velechit/HomeLAB/README.md

# HomeLAB
A miniature electronics lab (Oscilloscope + FuncGen + Breadboard + Arduino) for hobbyists
