velechit/HomeLAB/board/Oscilloscope/README.md

This directory will contain the KiCad project of the HomeLAB Oscilloscope
