velechit/HomeLAB/board/FuncGen/doc/board.pdf

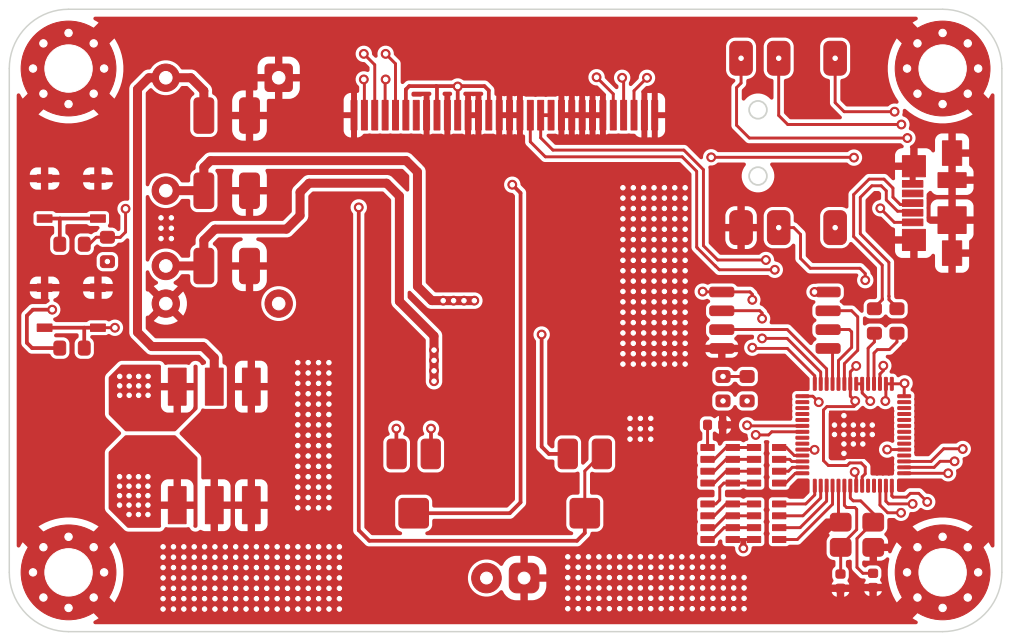
[picture p1: page 1]

Id: 1/8 Title: File: FuncGen.kicad_pcb Sheet:

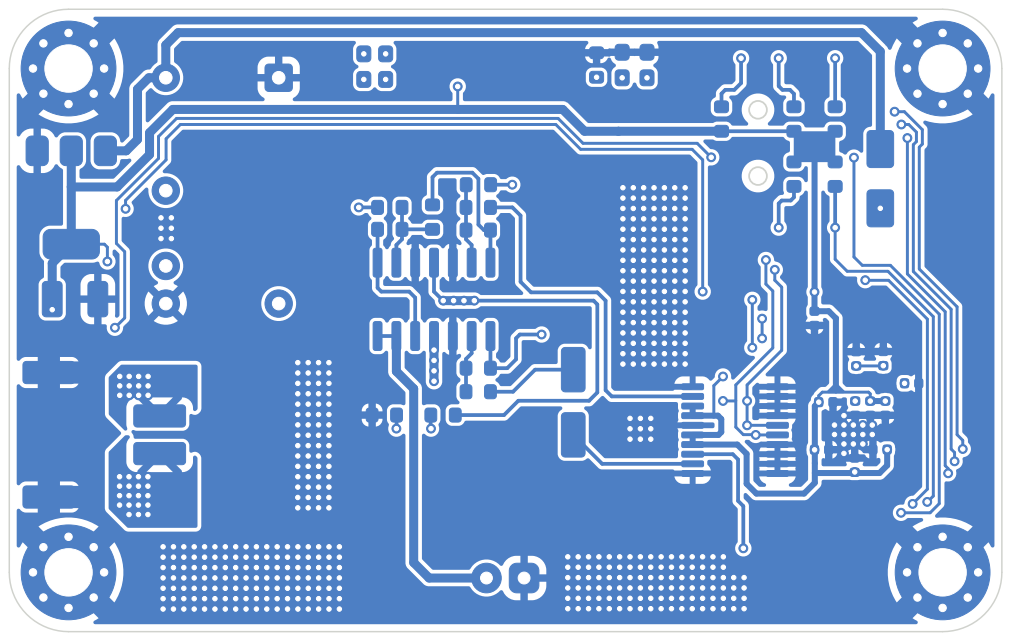
[picture p2: page 2]

Id: 2/8 Title: File: FuncGen.kicad_pcb Sheet:

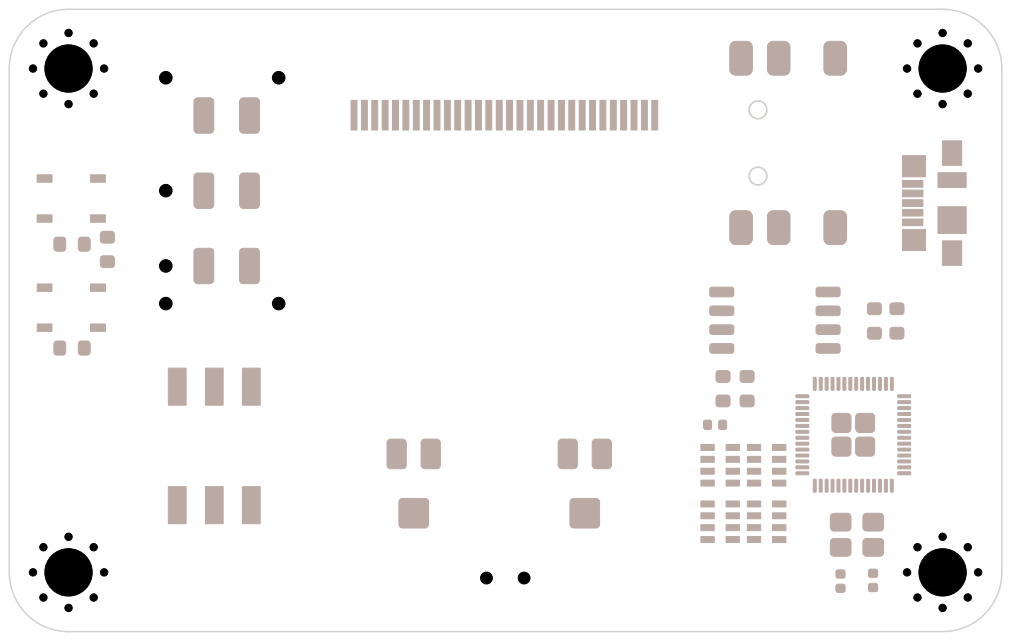
[picture p3: page 3]

Id: 3/8 Title: File: FuncGen.kicad_pcb Sheet:

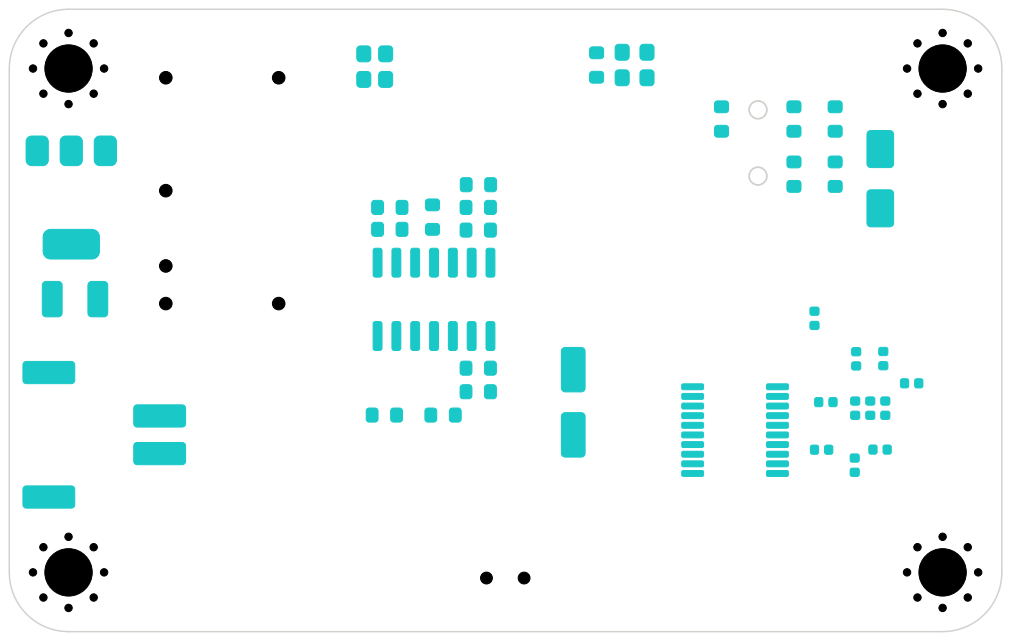
[picture p4: page 4]

Id: 4/8 Title: File: FuncGen.kicad_pcb Sheet:

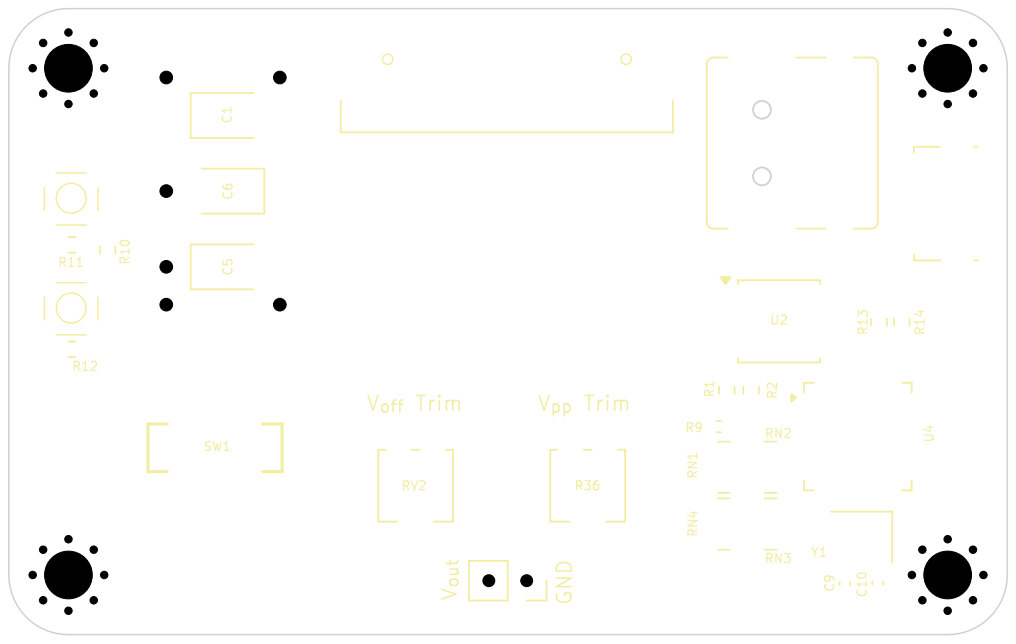
[picture p5: page 5]

Id: 5/8 Title: File: FuncGen.kicad_pcb Sheet:

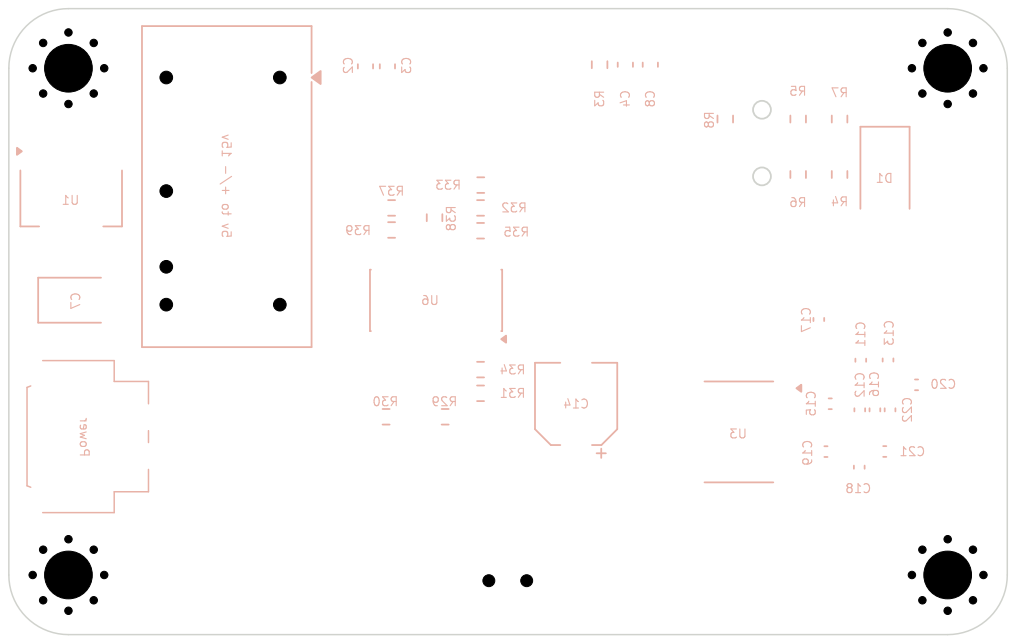
[picture p6: page 6]

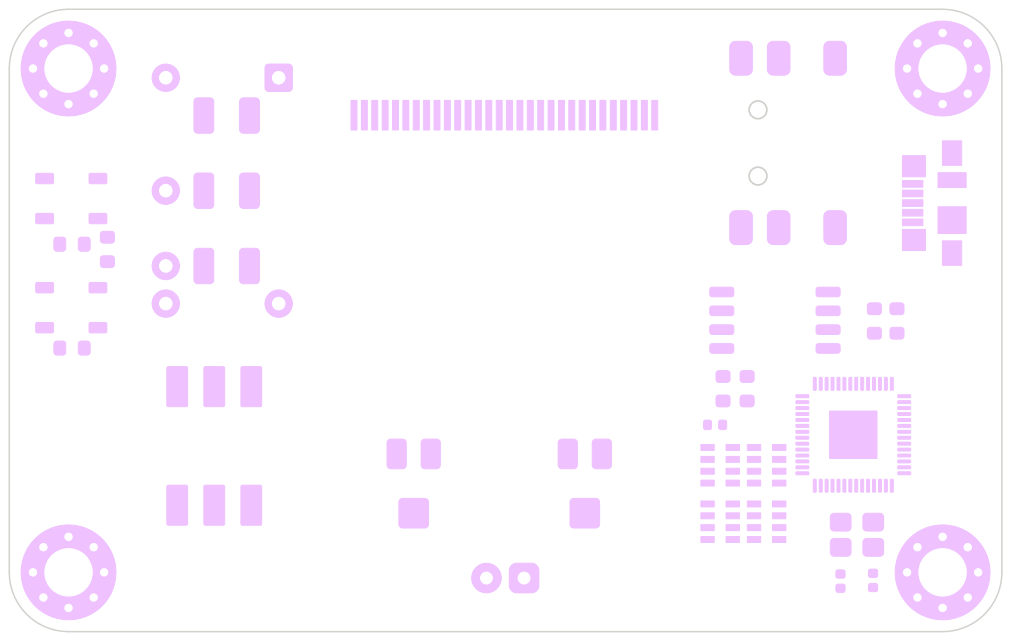
[picture p7: page 7]

Id: 7/8 Title: File: FuncGen.kicad_pcb Sheet:

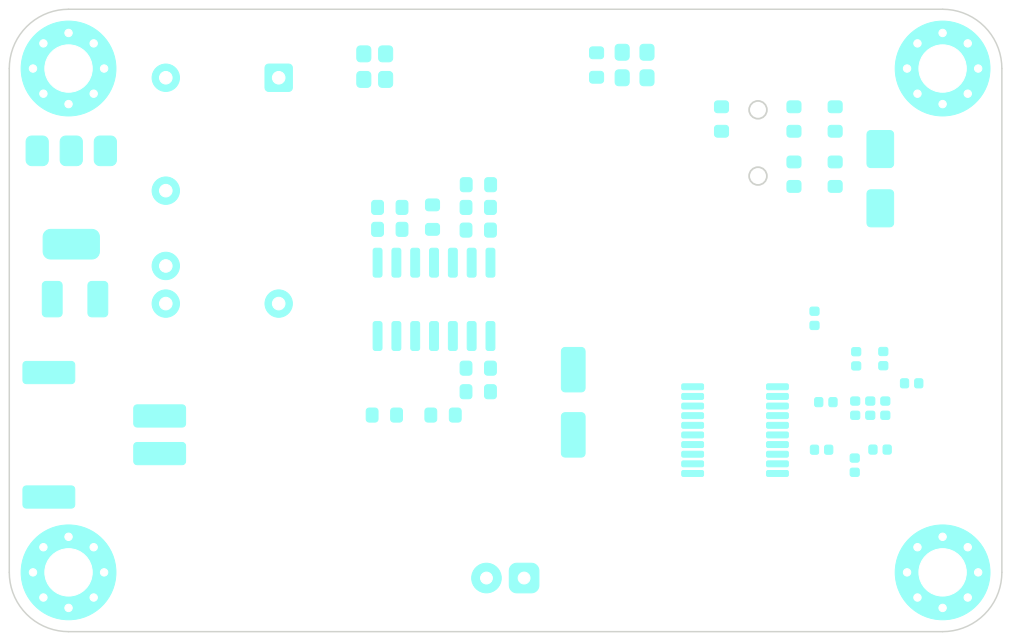
[picture p8: page 8]

Id: 8/8 Title: File: FuncGen.kicad_pcb Sheet:
