velechit/HomeLAB/board/FuncGen/doc/schematic.pdf

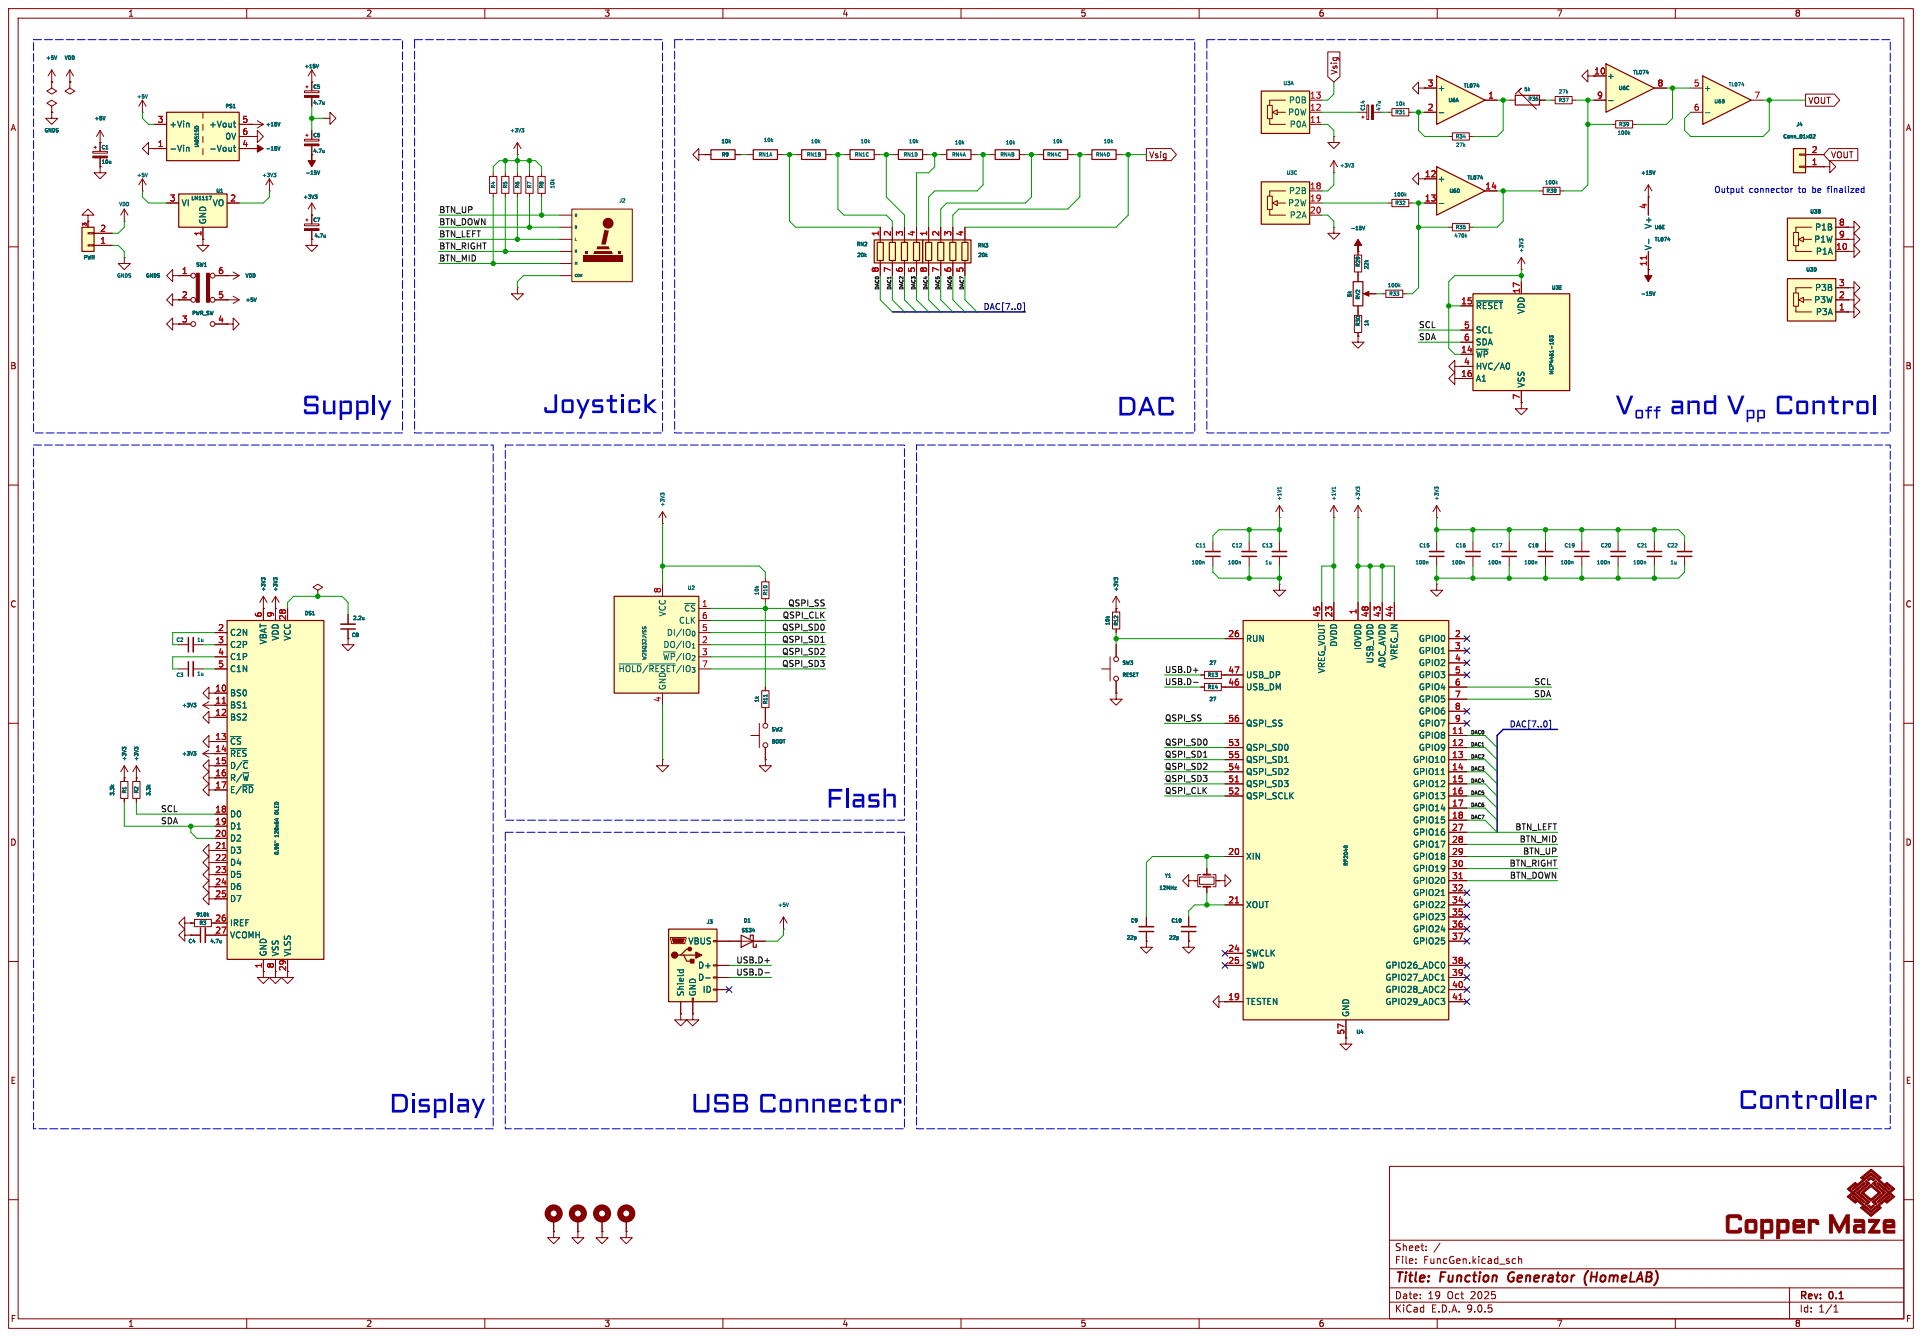
[picture p9: page 1]

V_{off} and V_{pp} Control

SW2 BOOT ~{CS}1 CLK 6 DI/IO_{0}5 DO/IO_{1}2 ~{WP}/IO_{2} 3 ~{HOLD}/~{RESET}/IO_{3} 7 VCC
