velechit/HomeLAB/board/FuncGen/FuncGen.kicad_pcb

## KiCad design board/FuncGen/FuncGen.kicad_pcb (2025-10-31)

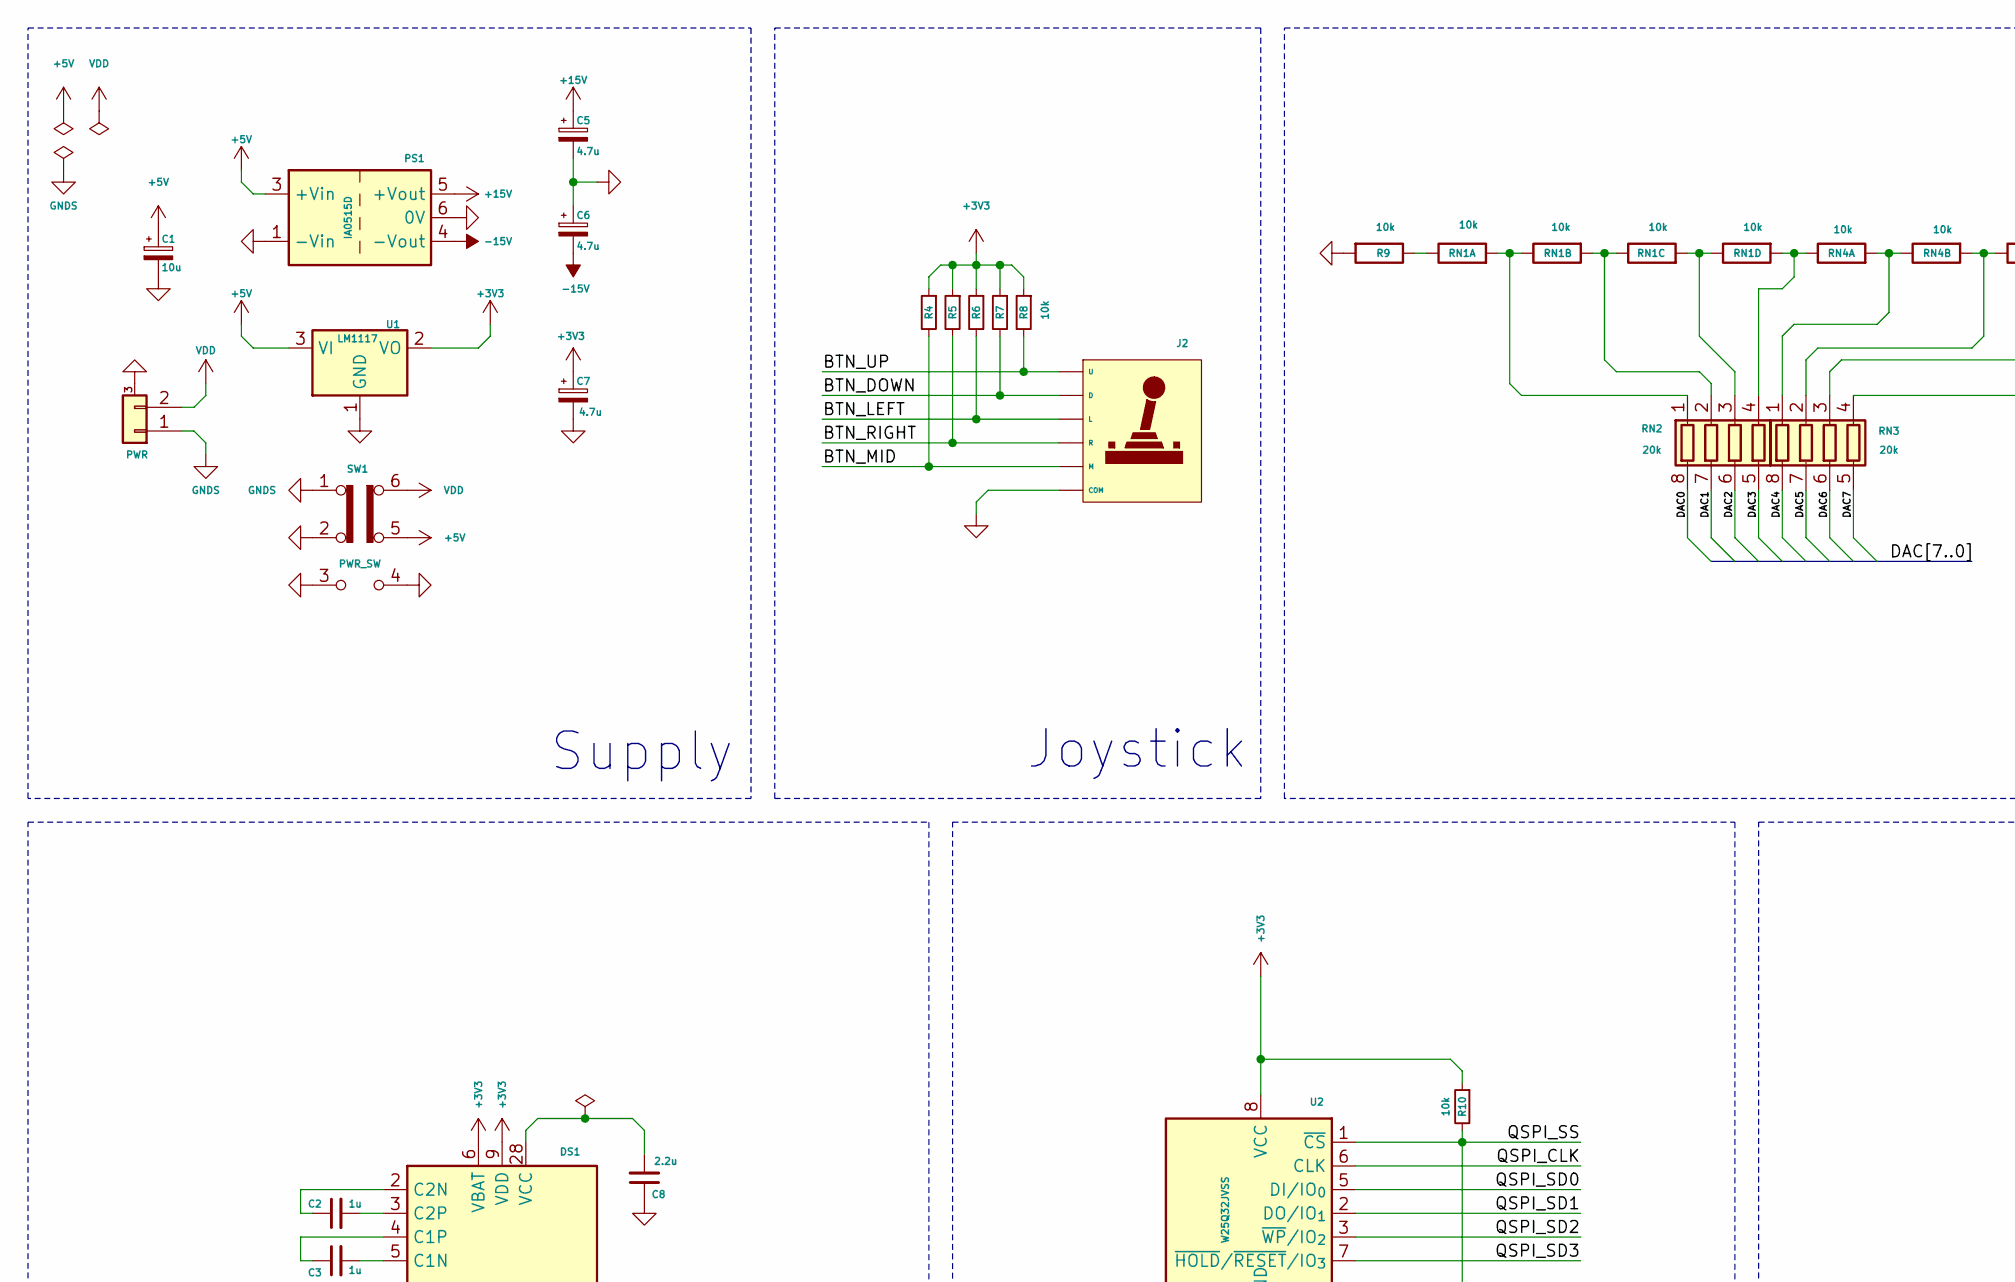
[picture p10: schematic FuncGen.kicad_sch, Function Generator (HomeLAB), part in row 1, column 1]

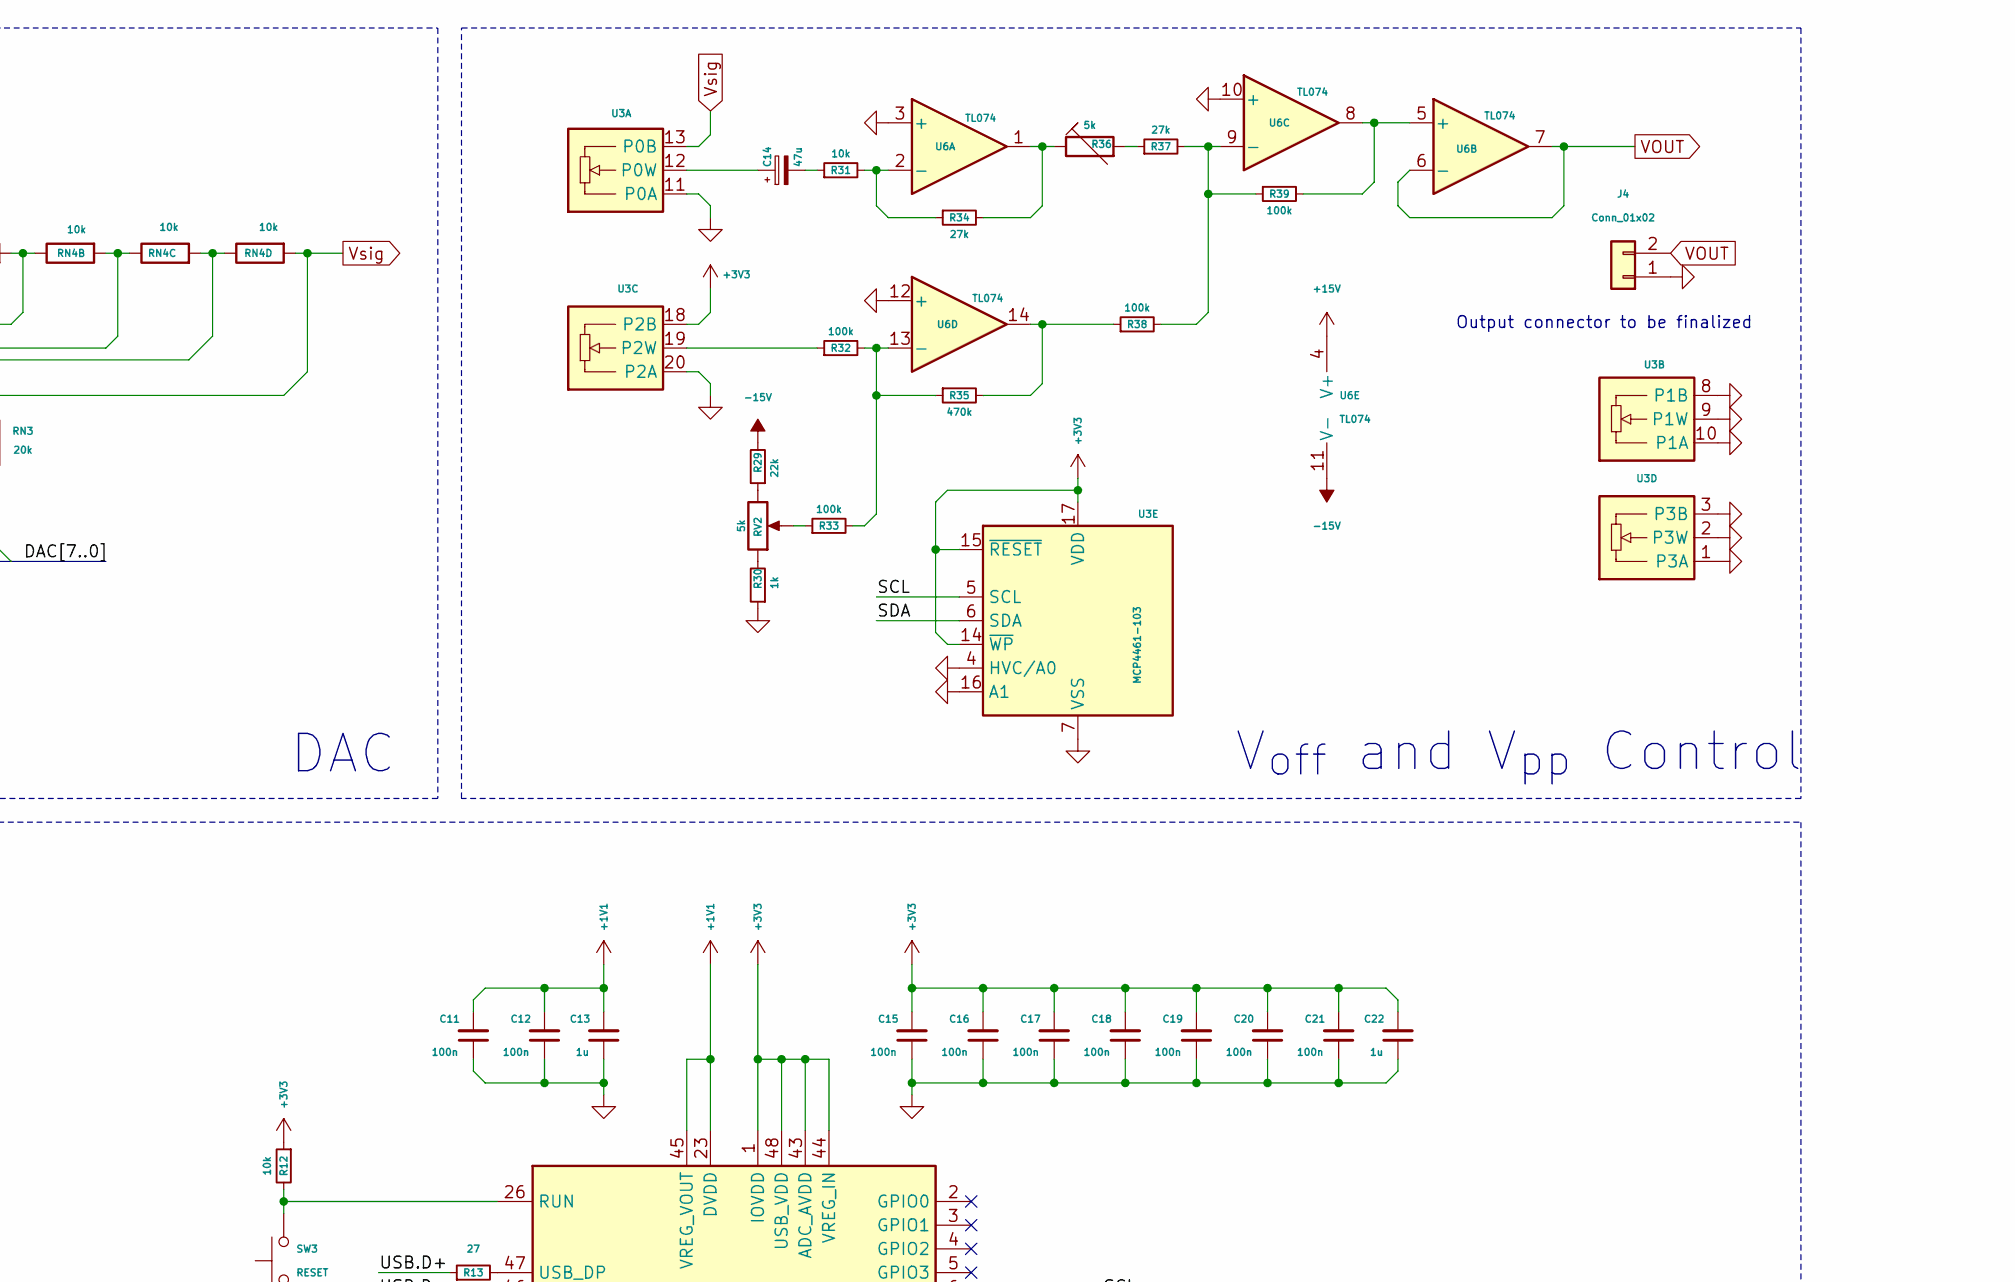
[picture p11: schematic FuncGen.kicad_sch, Function Generator (HomeLAB), part in row 1, column 2]

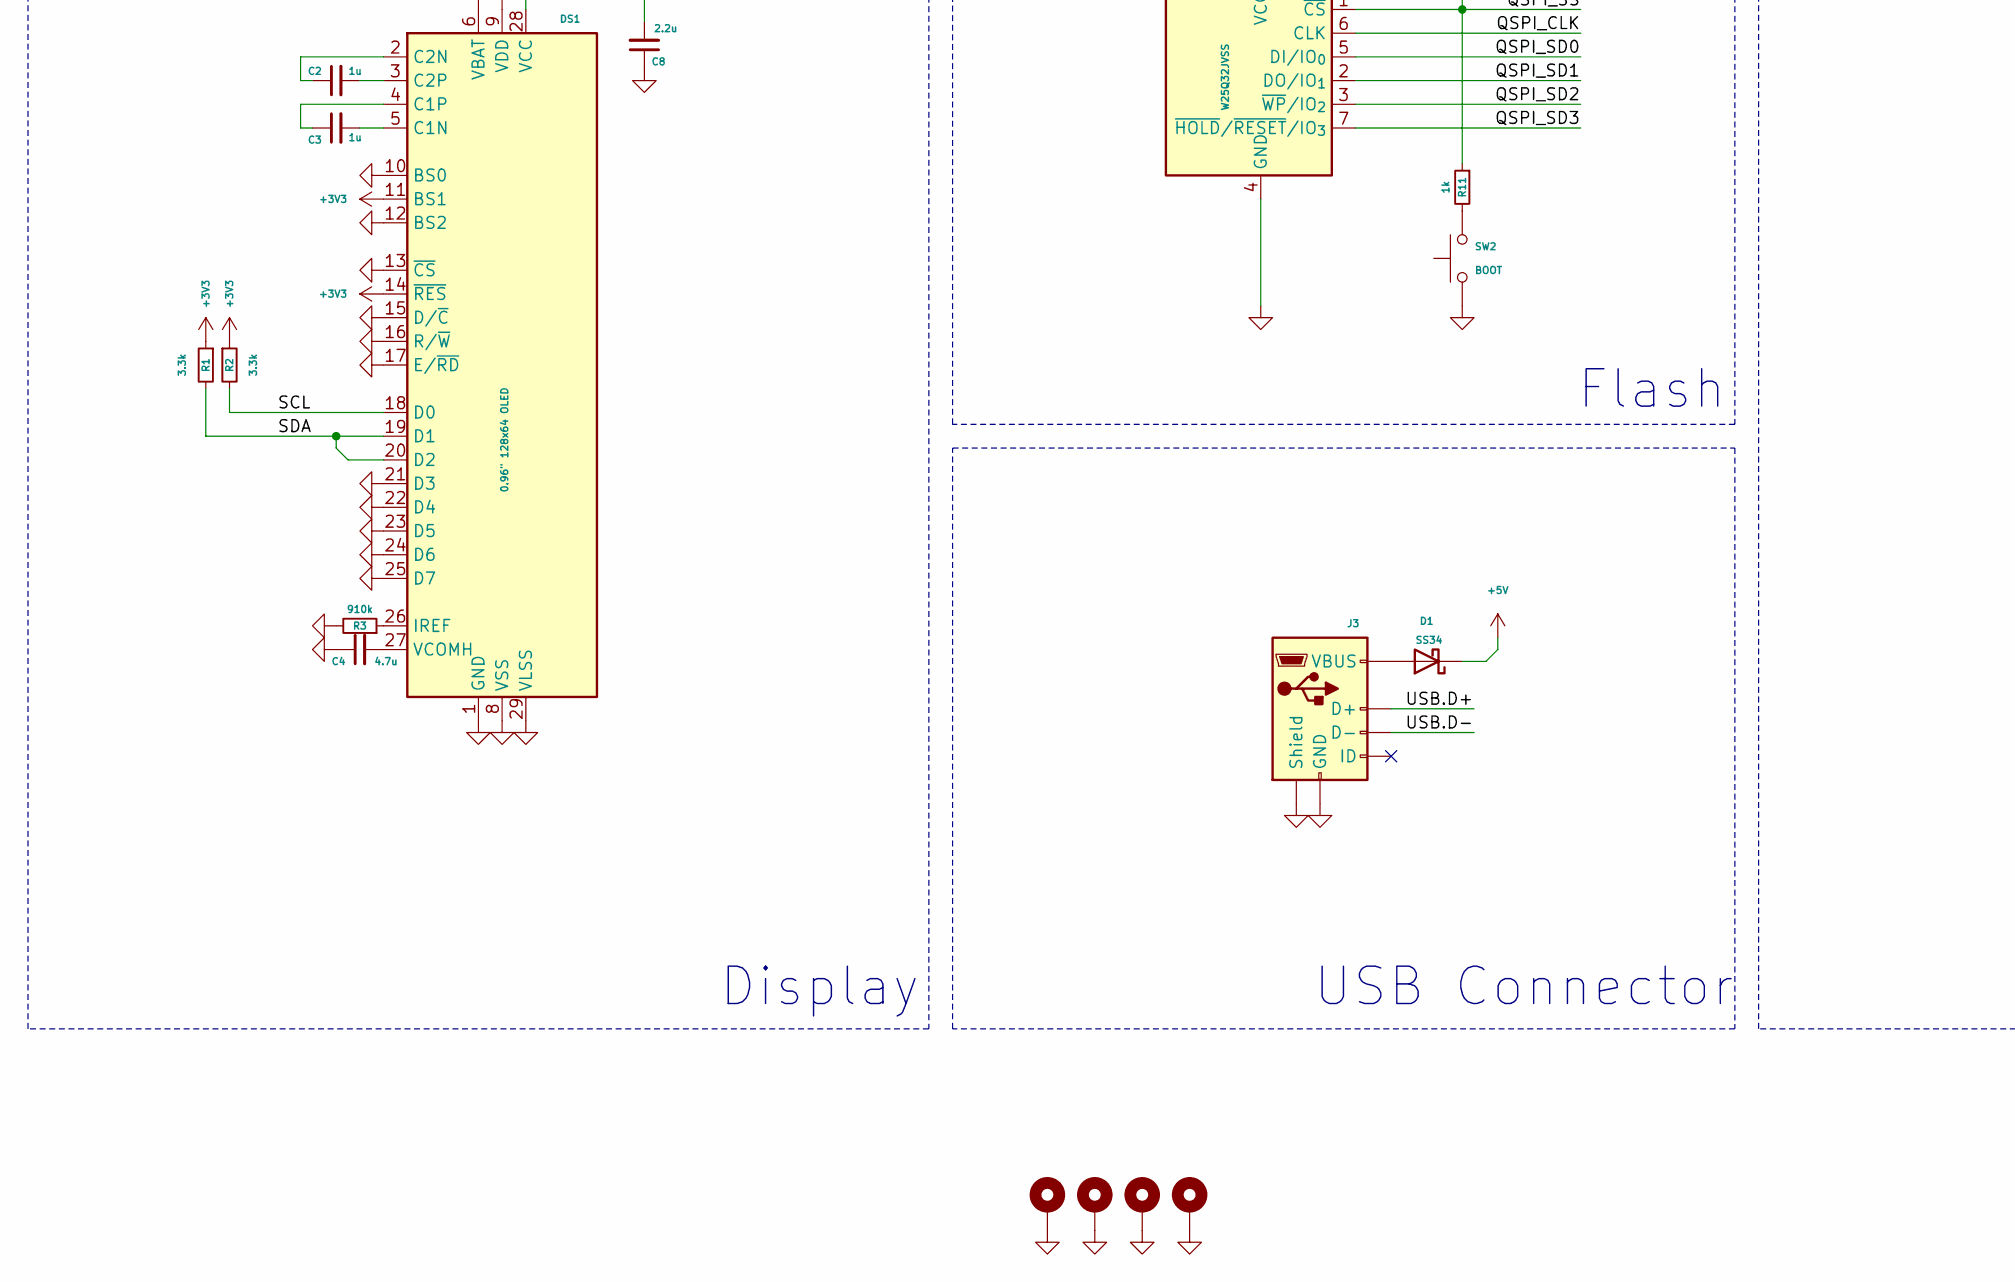
[picture p12: schematic FuncGen.kicad_sch, Function Generator (HomeLAB), part in row 2, column 1]

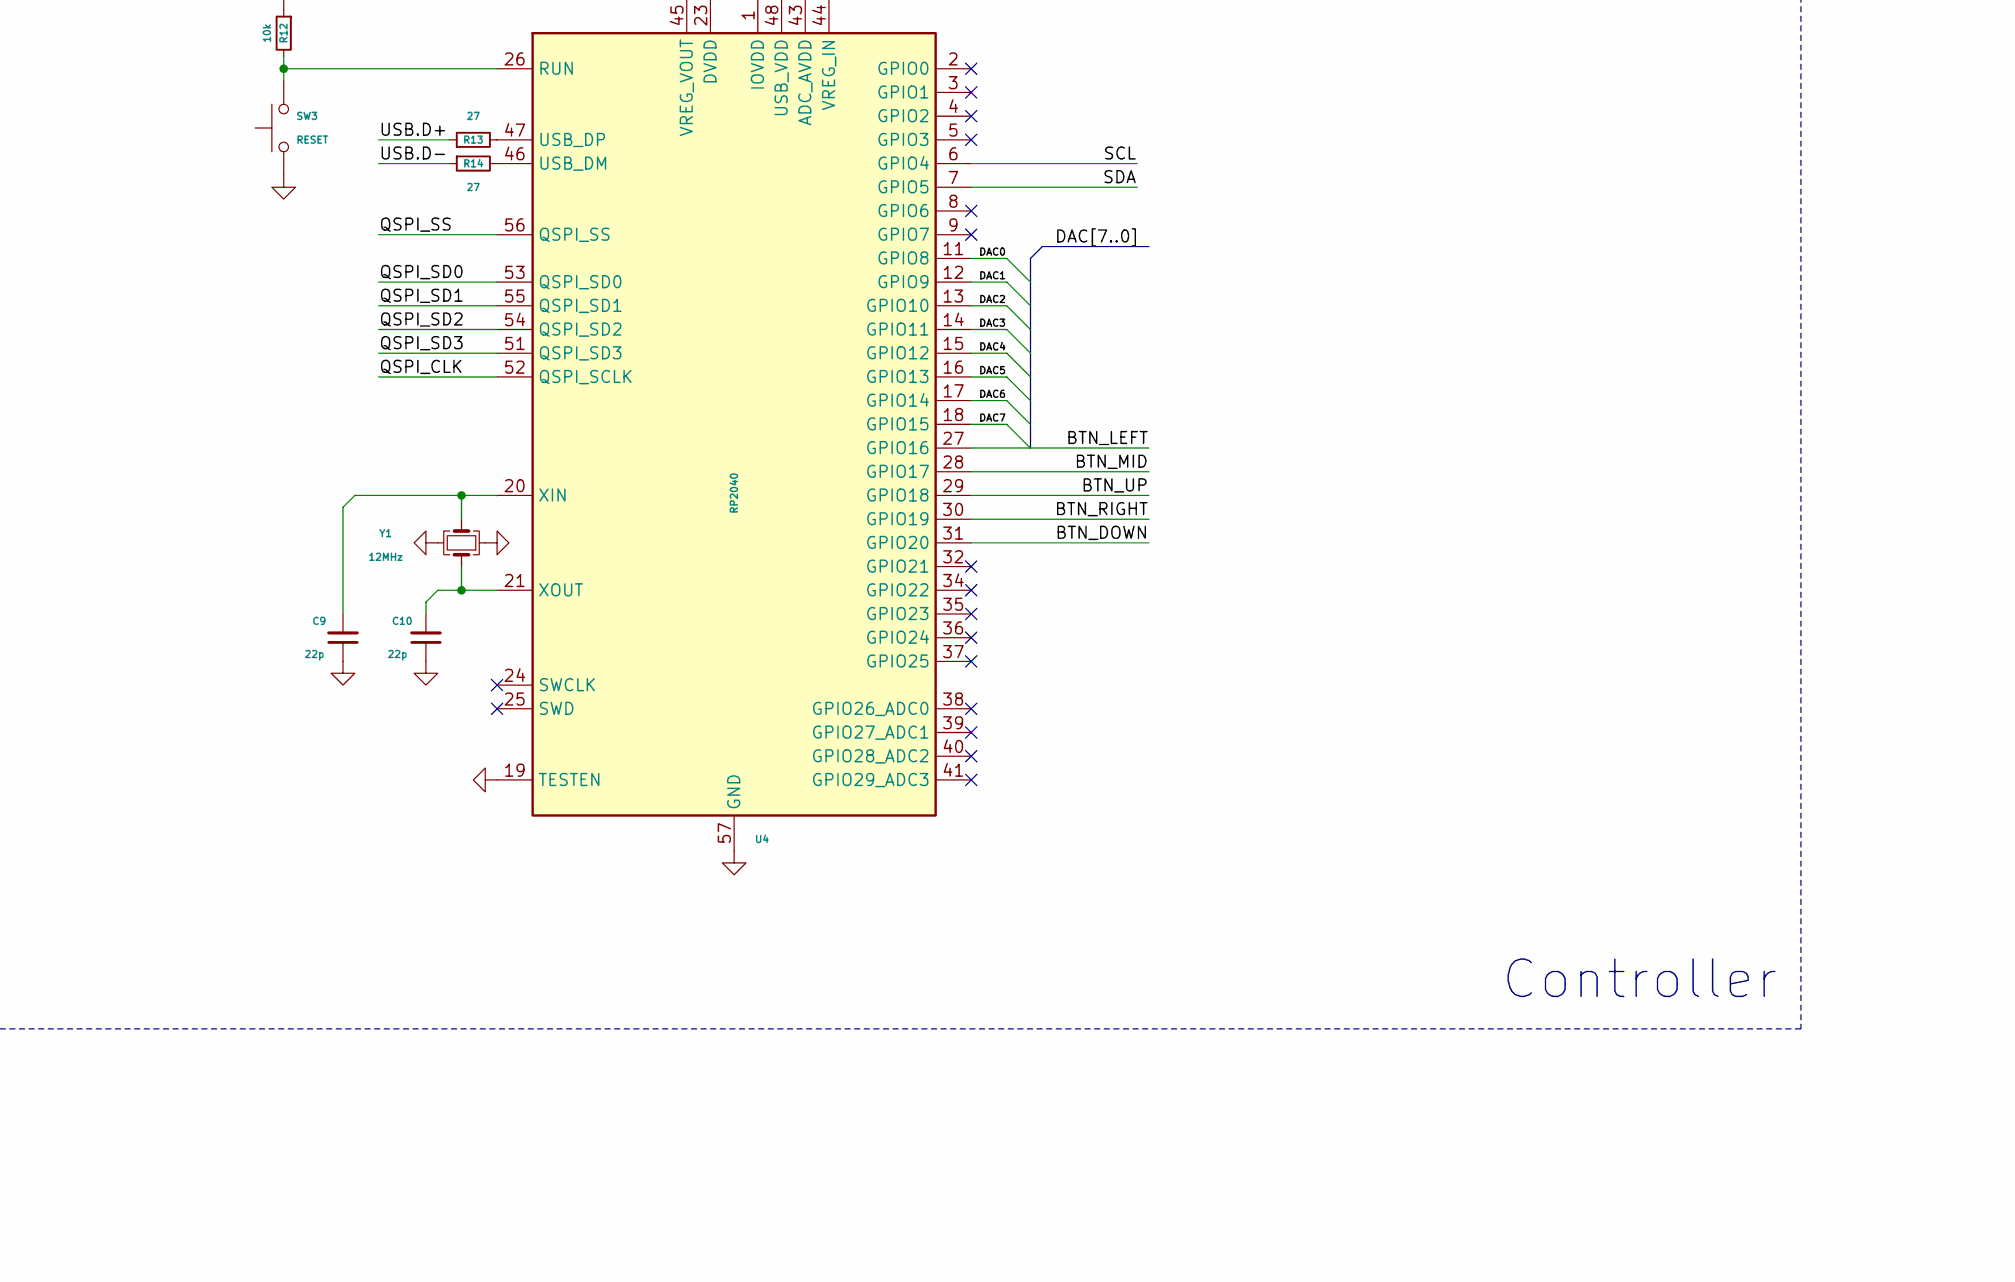
[picture p13: schematic FuncGen.kicad_sch, Function Generator (HomeLAB), part in row 2, column 2]

Parts:
C1: 10u; CP_EIA-3528-21_Kemet-B
C2, C3: 1u; C_0603_1608Metric_Pad1.08x0.95mm_HandSolder
C4: 4.7u; C_0603_1608Metric_Pad1.08x0.95mm_HandSolder
C5, C6, C7: 4.7u; CP_EIA-3528-21_Kemet-B
C8: 2.2u; C_0603_1608Metric_Pad1.08x0.95mm_HandSolder
C9, C10: 22p; C_0402_1005Metric
C11, C12, C15, C16, C17, C18, C19, C20, C21: 100n; C_0402_1005Metric
C13, C22: 1u; C_0402_1005Metric
C14: 47u; CP_Elec_5x5.4
D1: SS34; D_SMA
DS1: 0.96" 128x64 OLED; OLED-128O064D
H1, H2, H3, H4: MountingHole_Pad; MountingHole_3.2mm_M3_Pad_Via
J1: PWR; batt-conn
J2: joystick-sleek
J3: USB_B_Micro; USB_Micro-B_Molex_47346-0001
J4: Conn_01x02; PinSocket_1x02_P2.54mm_Vertical
PS1: IA0515D; Converter_DCDC_XP_POWER-IAxxxxD_THT
R1, R2: 3.3k; R_0603_1608Metric
R3: 910k; R_0603_1608Metric
R4, R5, R6, R7, R8, R10, R12, R31: 10k; R_0603_1608Metric
R9: 10k; R_0402_1005Metric
R11, R30: 1k; R_0603_1608Metric
R13, R14: 27; R_0603_1608Metric
R29: 22k; R_0603_1608Metric
R32, R33, R38, R39: 100k; R_0603_1608Metric
R34, R37: 27k; R_0603_1608Metric
R35: 470k; R_0603_1608Metric
R36: 5k; Potentiometer_Bourns_3224J_Horizontal
RN1, RN4: 10k; R_Array_Concave_4x0603
RN2, RN3: 20k; R_Array_Concave_4x0603
RV2: 5k; Potentiometer_Bourns_3224J_Horizontal
SW1: PWR_SW; DPDT_SMT
SW2: BOOT; 4PINSW-MINI
SW3: RESET; 4PINSW-MINI
U1: LM1117; SOT-223-3_TabPin2
U2: W25Q32JVSS; SOIC-8_5.3x5.3mm_P1.27mm
U3: MCP4461-103; TSSOP-20_4.4x6.5mm_P0.65mm
U4: RP2040; QFN-56-1EP_7x7mm_P0.4mm_EP3.2x3.2mm
U6: TL074; SOIC-14_3.9x8.7mm_P1.27mm
Y1: 12MHz; Crystal_SMD_3225-4Pin_3.2x2.5mm

Connections:
+1V1: C11.2, C12.2, C13.2, U4.23 (DVDD), U4.45 (VREG_VOUT), U4.50 (DVDD)
+3V3: C7.1, C15.2, C16.2, C17.2, C18.2, C19.2, C20.2, C21.2, C22.2, DS1.6 (VBAT), DS1.9 (VDD), DS1.11 (BS1), DS1.14 (~RES), R1.1, R2.1, R4.1, R5.1, R6.1, R7.1, R8.1, R10.1, R12.1, U1.2 (VO), U2.8 (VCC), U3.14 (~WP), U3.15 (~RESET), U3.17 (VDD), U3.18 (P2B), U4.1 (IOVDD), U4.10 (IOVDD), U4.22 (IOVDD), U4.33 (IOVDD), U4.42 (IOVDD), U4.43 (ADC_AVDD), U4.44 (VREG_IN), U4.48 (USB_VDD), U4.49 (IOVDD)
+5V: C1.1, D1.1 (K), PS1.3 (+Vin), SW1.5 (B), U1.3 (VI)
+15V: C5.1, PS1.5 (+Vout), U6.4 (V+)
-15V: C6.2, PS1.4 (-Vout), R29.2, U6.11 (V-)
/BTN_DOWN: J2.D, R7.2, U4.31 (GPIO20)
/BTN_LEFT: J2.L, R6.2, U4.27 (GPIO16)
/BTN_MID: J2.M, R4.2, U4.28 (GPIO17)
/BTN_RIGHT: J2.R, R5.2, U4.30 (GPIO19)
/BTN_UP: J2.U, R8.2, U4.29 (GPIO18)
/DAC0: RN2.8 (R1.2), U4.11 (GPIO8)
/DAC1: RN2.7 (R2.2), U4.12 (GPIO9)
/DAC2: RN2.6 (R3.2), U4.13 (GPIO10)
/DAC3: RN2.5 (R4.2), U4.14 (GPIO11)
/DAC4: RN3.8 (R1.2), U4.15 (GPIO12)
/DAC5: RN3.7 (R2.2), U4.16 (GPIO13)
/DAC6: RN3.6 (R3.2), U4.17 (GPIO14)
/DAC7: RN3.5 (R4.2), U4.18 (GPIO15)
/QSPI_CLK: U2.6 (CLK), U4.52 (QSPI_SCLK)
/QSPI_SD0: U2.5 (DI/IO_{0}), U4.53 (QSPI_SD0)
/QSPI_SD1: U2.2 (DO/IO_{1}), U4.55 (QSPI_SD1)
/QSPI_SD2: U2.3 (~WP/IO_{2}), U4.54 (QSPI_SD2)
/QSPI_SD3: U2.7 (~HOLD/~RESET/IO_{3}), U4.51 (QSPI_SD3)
/QSPI_SS: R10.2, R11.1, U2.1 (~CS), U4.56 (QSPI_SS)
/SCL: DS1.18 (D0), R2.2, U3.5 (SCL), U4.6 (GPIO4)
/SDA: DS1.19 (D1), DS1.20 (D2), R1.2, U3.6 (SDA), U4.7 (GPIO5)
/USB.D+: J3.3 (D+), R13.1
/USB.D-: J3.2 (D-), R14.1
GND: C1.2, C4.1, C5.2, C6.1, C7.2, C8.1, C9.1, C10.1, C11.1, C12.1, C13.1, C15.1, C16.1, C17.1, C18.1, C19.1, C20.1, C21.1, C22.1, DS1.1 (GND), DS1.8 (VSS), DS1.10 (BS0), DS1.12 (BS2), DS1.13 (~CS), DS1.15 (D/~C), DS1.16 (R/~W), DS1.17 (E/~RD), DS1.21 (D3), DS1.22 (D4), DS1.23 (D5), DS1.24 (D6), DS1.25 (D7), DS1.29 (VLSS), DS1.30 (GND), H1.1, H2.1, H3.1, H4.1, J1.3, J2.COM, J3.5 (GND), J3.6 (Shield), J4.1, PS1.1 (-Vin), PS1.6 (0V), R3.2, R9.2, R30.1, SW1.2 (B), SW1.3 (C), SW1.4 (A), SW2.1, SW3.1, U1.1 (GND), U2.4 (GND), U3.1 (P3A), U3.2 (P3W), U3.3 (P3B), U3.4 (HVC/A0), U3.7 (VSS), U3.8 (P1B), U3.9 (P1W), U3.10 (P1A), U3.11 (P0A), U3.16 (A1), U3.20 (P2A), U4.19 (TESTEN), U4.57 (GND), U6.3 (+), U6.10 (+), U6.12 (+), Y1.2, Y1.4
GNDS: J1.1, SW1.1 (A)
unnamed: C14.2, R31.1
unnamed: D1.2 (A), J3.1 (VBUS)
unnamed: C3.2, DS1.5 (C1N)
unnamed: C3.1, DS1.4 (C1P)
unnamed: C2.1, DS1.2 (C2N)
unnamed: C2.2, DS1.3 (C2P)
unnamed: DS1.26 (IREF), R3.1
unnamed: C8.2, DS1.28 (VCC)
unnamed: C4.2, DS1.27 (VCOMH)
unnamed: R11.2, SW2.2
unnamed: R29.1, RV2.3
unnamed: R30.2, RV2.1
unnamed: R33.1, RV2.2
unnamed: R34.2, R36.1, U6.1
unnamed: R35.2, R38.1, U6.14
unnamed: R36.2, R36.3, R37.1
unnamed: R9.1, RN1.1 (R1.1)
unnamed: RN1.2 (R2.1), RN1.8 (R1.2), RN2.1 (R1.1)
unnamed: RN1.3 (R3.1), RN1.7 (R2.2), RN2.2 (R2.1)
unnamed: RN1.4 (R4.1), RN1.6 (R3.2), RN2.3 (R3.1)
unnamed: RN1.5 (R4.2), RN2.4 (R4.1), RN4.1 (R1.1)
unnamed: RN3.1 (R1.1), RN4.2 (R2.1), RN4.8 (R1.2)
unnamed: RN3.2 (R2.1), RN4.3 (R3.1), RN4.7 (R2.2)
unnamed: RN3.3 (R3.1), RN4.4 (R4.1), RN4.6 (R3.2)
unnamed: C14.1, U3.12 (P0W)
unnamed: R32.1, U3.19 (P2W)
unnamed: R12.2, SW3.2, U4.26 (RUN)
unnamed: R14.2, U4.46 (USB_DM)
unnamed: R13.2, U4.47 (USB_DP)
unnamed: C9.2, U4.20 (XIN), Y1.3
unnamed: C10.2, U4.21 (XOUT), Y1.1
unnamed: R31.2, R34.1, U6.2 (-)
unnamed: R39.2, U6.5 (+), U6.8
unnamed: R37.2, R38.2, R39.1, U6.9 (-)
unnamed: R32.2, R33.2, R35.1, U6.13 (-)
VDD: J1.2, SW1.6 (C)
VOUT: J4.2, U6.6 (-), U6.7
Vsig: RN3.4 (R4.1), RN4.5 (R4.2), U3.13 (P0B)

Notes on the sheet:
Output connector to be finalized
Supply
Controller
Joystick
USB Connector
Flash
DAC
Display
V_{off} and V_{pp} Control

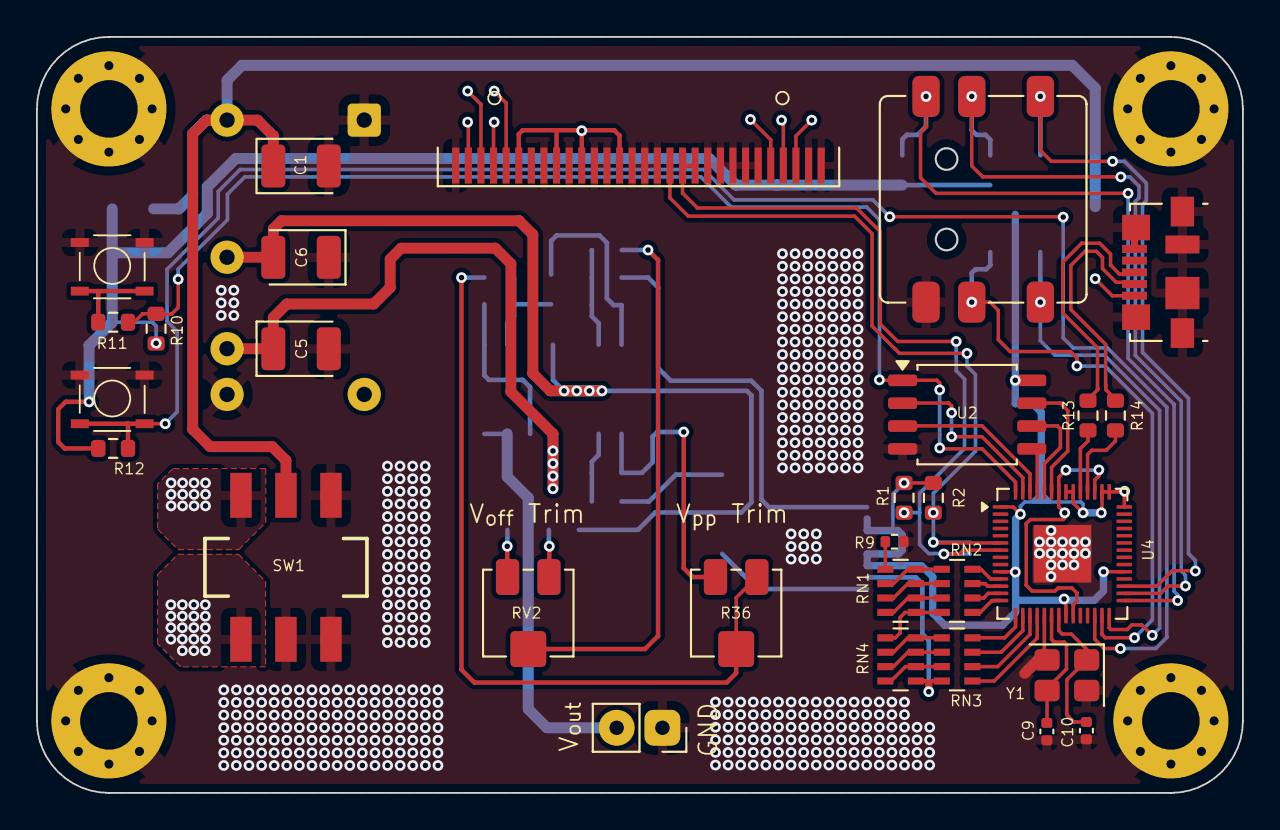
[picture p14: board FuncGen.kicad_pcb from above]

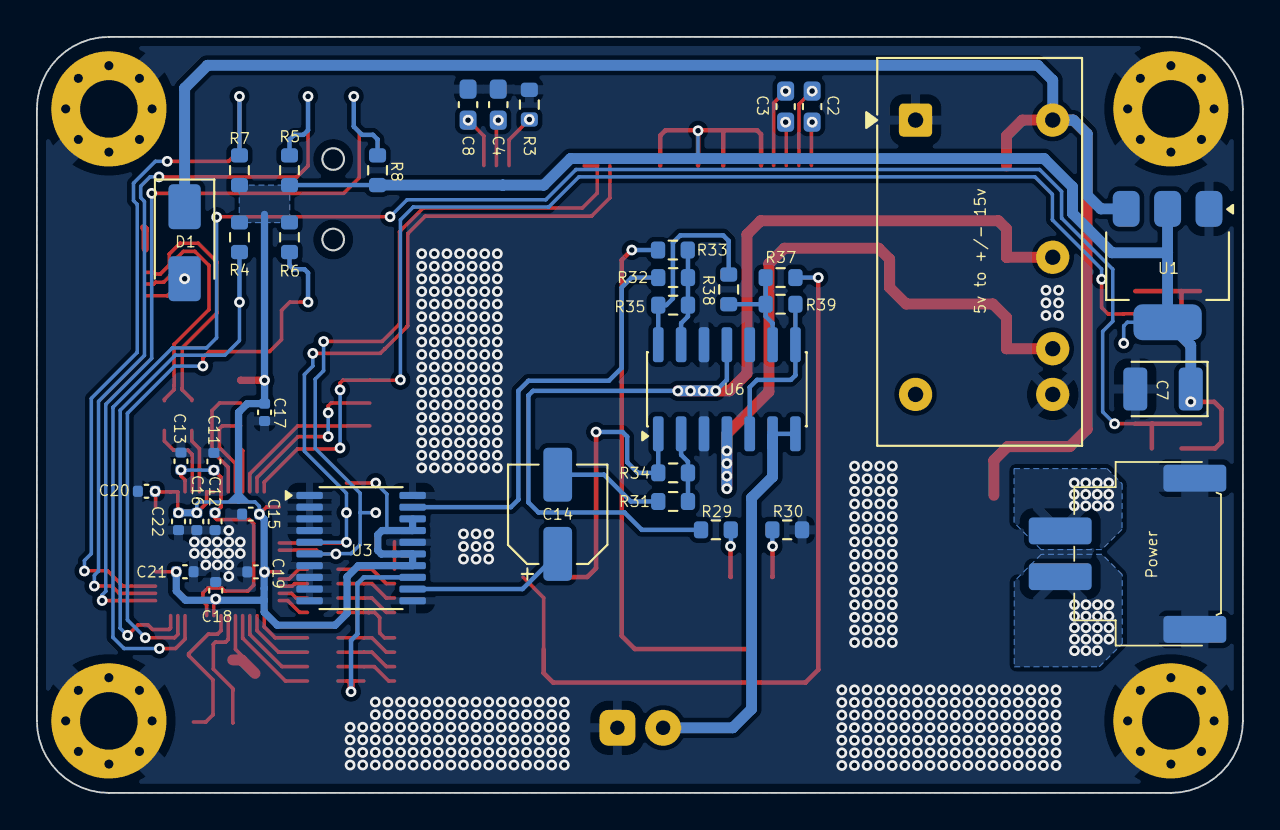
[picture p15: board FuncGen.kicad_pcb from below]

Board: 2 copper layers, 67.0 x 42.0 mm, 72 parts (39 on the bottom side), 68 nets.
