velechit/HomeLAB/(commit log)

2025-10-31 Initial commit for Function Gemerator PCB
    [FuncGen-B_Cu.gbr, FuncGen-B_Mask.gbr, FuncGen-B_Paste.gbr, FuncGen-B_Silkscreen.gbr, FuncGen-Edge_Cuts.gbr, FuncGen-F_Cu.gbr, FuncGen-F_Mask.gbr, FuncGen-F_Paste.gbr]
2025-10-31 Placeholder for Oscilloscope board design
